X-Green/Super-Cap-Notes-2023/demo_h_bridge.kicad_sch

## KiCad design demo_h_bridge.kicad_sch (2023-04-30)

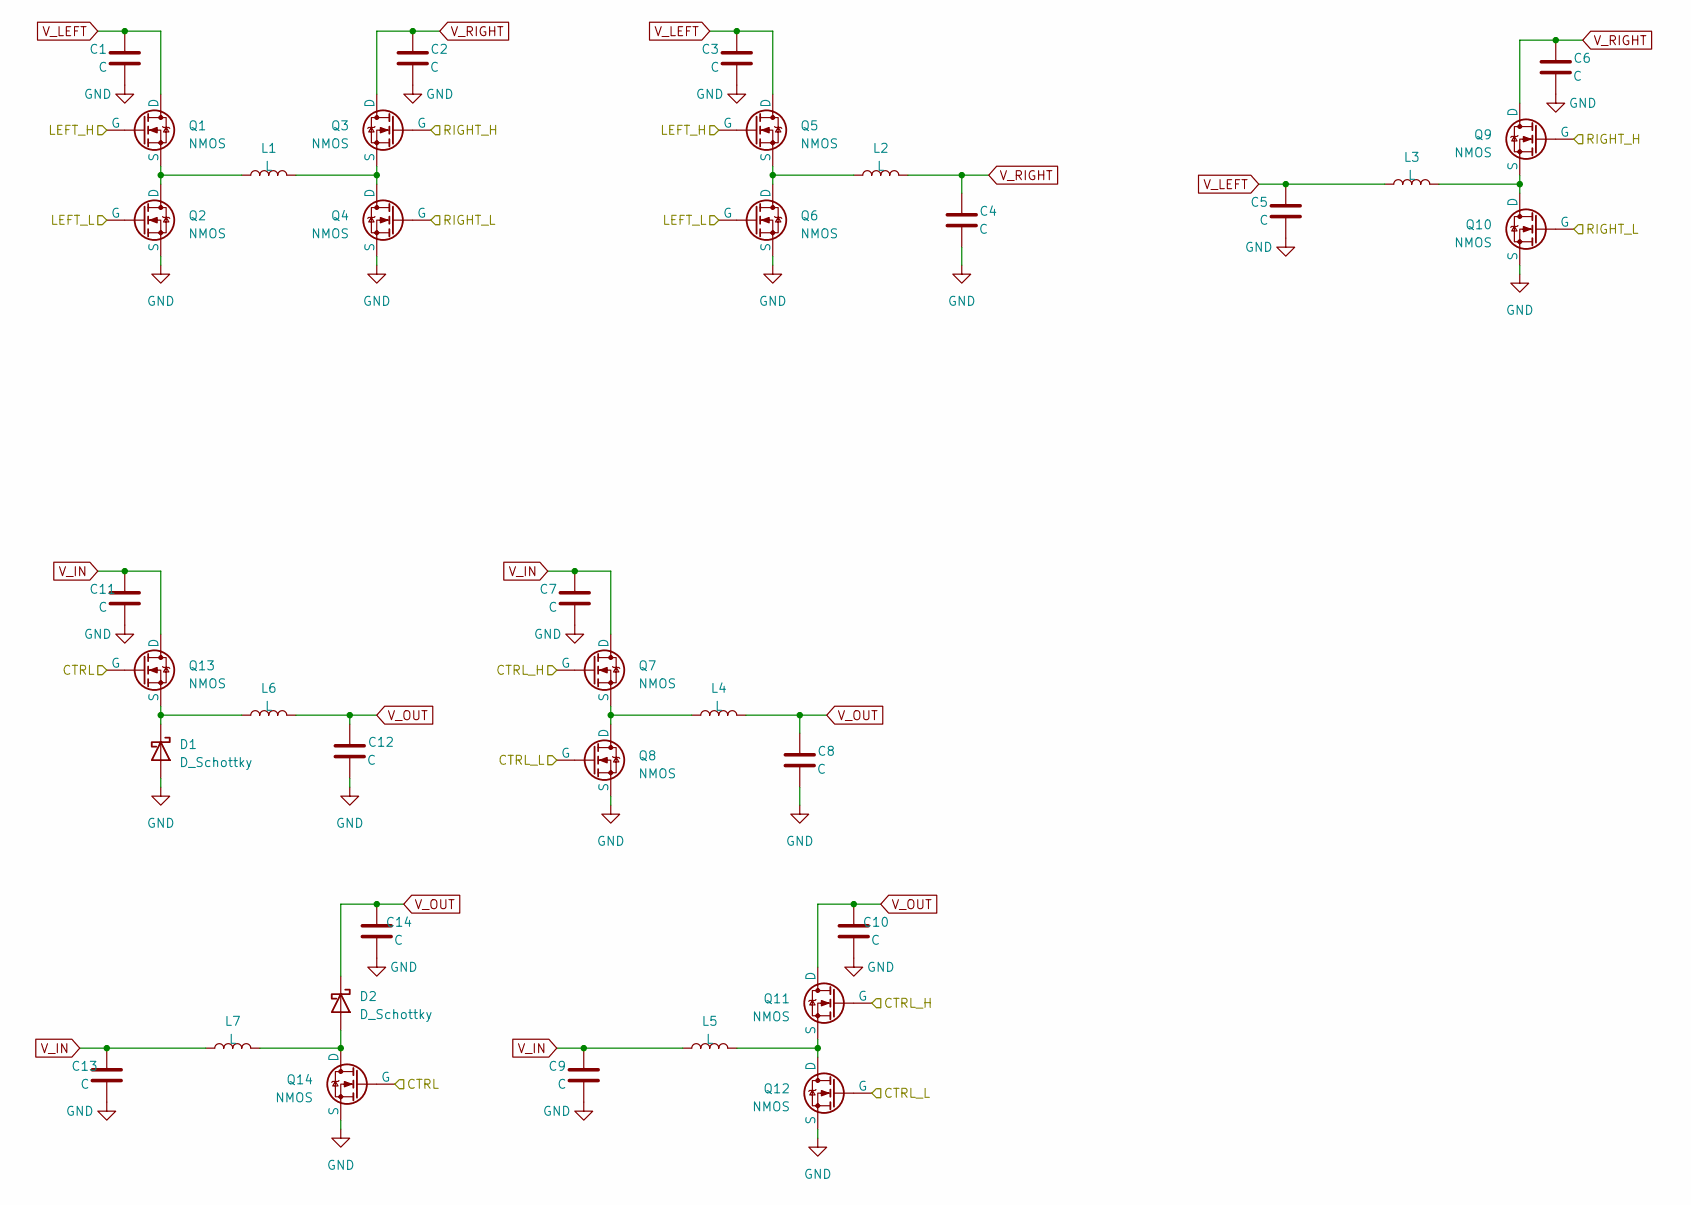
[picture p11: schematic demo_h_bridge.kicad_sch]

Parts:
C1, C2, C3, C4, C5, C6, C7, C8, C9, C10, C11, C12, C13, C14: C
D1, D2: D_Schottky
L1, L2, L3, L4, L5, L6, L7: L
Q1, Q2, Q3, Q4, Q5, Q6, Q7, Q8, Q9, Q10, Q11, Q12, Q13, Q14: NMOS

Connections:
CTRL: Q13.2 (G), Q14.2 (G)
CTRL_H: Q7.2 (G), Q11.2 (G)
CTRL_L: Q8.2 (G), Q12.2 (G)
GND: C1.2, C2.2, C3.2, C4.2, C5.2, C6.2, C7.2, C8.2, C9.2, C10.2, C11.2, C12.2, C13.2, C14.2, D1.2 (A), Q2.3 (S), Q4.3 (S), Q6.3 (S), Q8.3 (S), Q10.3 (S), Q12.3 (S), Q14.3 (S)
LEFT_H: Q1.2 (G), Q5.2 (G)
LEFT_L: Q2.2 (G), Q6.2 (G)
unnamed: D1.1 (K), L6.1, Q13.3 (S)
unnamed: D2.2 (A), L7.2, Q14.1 (D)
unnamed: L1.1, Q1.3 (S), Q2.1 (D)
unnamed: L1.2, Q3.3 (S), Q4.1 (D)
unnamed: L2.1, Q5.3 (S), Q6.1 (D)
unnamed: L3.2, Q9.3 (S), Q10.1 (D)
unnamed: L4.1, Q7.3 (S), Q8.1 (D)
unnamed: L5.2, Q11.3 (S), Q12.1 (D)
RIGHT_H: Q3.2 (G), Q9.2 (G)
RIGHT_L: Q4.2 (G), Q10.2 (G)
V_IN: C7.1, C9.1, C11.1, C13.1, L5.1, L7.1, Q7.1 (D), Q13.1 (D)
V_LEFT: C1.1, C3.1, C5.1, L3.1, Q1.1 (D), Q5.1 (D)
V_OUT: C8.1, C10.1, C12.1, C14.1, D2.1 (K), L4.2, L6.2, Q11.1 (D)
V_RIGHT: C2.1, C4.1, C6.1, L2.2, Q3.1 (D), Q9.1 (D)
