X-Green/Super-Cap-Notes-2023/(commit log)

2023-04-30 buck/boost converter topology
    [demo_h_bridge.kicad_sch]
2023-05-01 pid flowchart
2023-05-01 pid flowchart done
2023-05-01 pid flowchart fix
